king-getting/jiujiu-robot/docs/项目交接.md

# 啾啾 — 智能桌面聊天机器人 · 项目交接文档

> 最后更新：2026-08-23
> 交接对象：Kimi / KIMI Work
> 项目路径（Windows）：`C:\Users\89640\Documents\智能聊天机器人——啾啾\`

---

## 〇、2026-08-07 最新进展（追加）

| 事项 | 结果 |
|---|---|
| SD卡读写测试 | ✅ 跑通。坑：前几次失败根因是**MicroSD卡没插到底**，重插听到咔哒声后成功。测试代码见 `esp32/sd_test/` |
| 触摸调试 | ✅ **已定位（2026-08-14）**：根因=SD卡模块MISO霸占SPI总线（74HC125的OE焊死GND，空闲时把MISO钉高电平→读数8191）。拔掉SD模块MISO线后触摸恢复正常，TFT_eSPI `getTouch` 实测 `ok=1`、坐标/压力正常。详见下方"2026-08-14触摸排查结论" |
| BMP图片显示 | 代码已写（`esp32/bmp_test/`），用户侧编译报错exit status 1，报错原文未拿到，待定位 |
| Type-C读卡器 | ✅ 已到，可拷字体/图片进SD卡 |
| 手机APP | 需求+通信协议已定稿，见 `docs/手机APP开发交接.md`，交KIMI Work开发 |
| GitHub仓库 | ✅ 建立，持续同步 |

### 2026-08-14 触摸8191排查结论（已定位）

> 排查方式：arduino-cli 编译上传诊断程序 + 串口实测（诊断代码在 `03_ESP32代码\触摸调试\touch_bus_diag\`）

| 排查项 | 结论 |
|---|---|
| 恒定8191的直接原因 | **SD卡模块MISO霸占SPI总线**：带电平转换模块的74HC125缓冲芯片OE焊死GND，SD卡空闲时把MISO钉在高电平 → XPT2046读出来全是1（8191）。拔掉SD模块MISO线后触摸立即恢复正常 |
| TOUCH_CS配置 | `User_Setup.h`中`TOUCH_CS 21`必须保持启用（无`//`），曾被人为加注释，已纠正 |
| SPI触摸频率 | 2.5MHz → **1MHz**（`SPI_TOUCH_FREQUENCY`），低频率下读取更稳，已写入User_Setup.h |
| XPT2046芯片/触摸屏 | ✅ 完全正常：TFT_eSPI `getTouch` 返回 `ok=1`，坐标/压力读数正常（诊断v8实测） |
| CS链路（GPIO21→CS2） | ✅ 正常（诊断v7对照实验：选中/不选中读数不同） |

**遗留问题**：SD卡模块与触摸不能共存（MISO干扰）。解决方案（任选）：
1. 换3.3V直连、无电平转换的SD卡模块（¥5左右，无74HC125即无干扰）——推荐
2. 改造现有模块：把74HC125的OE脚从GND焊开，改接SD_CS（选中SD时才驱动MISO）
3. SD模块独立供电，触摸操作时断电（软件控制GPIO）

> 换新SD模块前，SD模块MISO线保持拔掉状态，触摸功能可正常使用。

---

---

## 〇.2、2026-08-22 半成品 v0.9（桌面摆件版）进展

> 目标：实现可演示的阶段性版本。核心演示 = **手机发消息 → WiFi/蓝牙 → ESP32 屏幕显示**。
> 已放弃（后续版本）：触摸交互 / SD卡 / 语音合成 / 中文字库。屏幕字体无中文字形，中文消息会显示为 `?`。

### 主程序 `esp32/jiujiu_main/jiujiu_main.ino`（v0.9，含BLE）

| 功能 | 说明 |
|---|---|
| 开机画面 | 粉底 + 狗头 + "JIUJIU / hello my friend" |
| 表情动画 | 可爱狗头 + 每3.2秒眨眼 |
| 鼓励语轮换 | 内置5句中文陪伴短句（我在呢/加油鸭/早点休息/今天也要开心/晚安），每12秒轮换 |
| WiFi | STA 连手机热点（`WIFI_SSID`/`WIFI_PWD`，需用户改）；失败自动切纯AP模式 |
| AP兜底 | SSID `Jiujiu` / 密码 `12345678` / IP `192.168.4.1` |
| HTTP接口 | `GET /`、`GET /api/status`、`GET /api/phrase/list`、`POST /api/message`、`GET /api/sensor`、`POST /api/phrase/add|del`（半成品仅回ok） |
| **BLE服务端** | 设备名 `JIUJIU`；服务/特征UUID与APP硬编码一致；写入JSON指令即上屏：`{ver:1,cmd:"msg",text:"..."}` → notify回执`{"ok":true}` |
| 传感器 | DHT11(GPIO26/27) + MQ-135(GPIO34) 已接并实测：串口每2秒输出温度/湿度/ADC |

> ⚠️ **编译必须指定 huge_app 分区**（BLE+TFT+WebServer 固件约1.75MB，超过默认1.25MB）：
> `arduino-cli compile --fqbn esp32:esp32:nodemcu-32s --build-property build.partitions=huge_app --build-property upload.maximum_size=3145728 <sketch>`
> 上传同理带 `--build-path`（产物内已含huge_app分区表）。

### 已实测（2026-08-22，PC直连AP验证）

- ✅ AP 正常广播、可连接（此前"找不到AP"是PC网卡只扫5GHz所致，非板子问题）
- ✅ `GET /` → `Jiujiu is alive! IP: 192.168.4.1 ...`
- ✅ `GET /api/status` → `{"ver":1,"ip":"192.168.4.1","wifi":false,"sd":false,"battery":0}`
- ✅ `GET /api/phrase/list` → 6句鼓励语JSON
- ⏳ `POST /api/message` 待手机APP实测（代码逻辑与APP协议一致：JSON body 进 `arg("plain")`，已核对WebServer源码）

### 课堂演示步骤（手机）

**方案A：蓝牙直连（推荐，无需WiFi）**
1. 开ESP32电源，等3秒（BLE 已在广播，设备名 `JIUJIU`）
2. 手机装 **nRF Connect**（免费）→ 扫描 → 连接 `JIUJIU`
3. 找到服务 `6a696f00-...` 下的写特征 `6a696f01-...` → 写入 `{"ver":1,"cmd":"msg","text":"I love you"}`（UTF-8）
4. 屏幕显示10秒；写特征 `6a696f02-...` 开启notify可收到回执 `{"ok":true}`

**方案B：WiFi + APP（啾啾APP完整功能）**
1. 开ESP32电源，等10秒进入AP模式（串口打印 `[WiFi] AP mode IP=192.168.4.1`）
2. 手机WiFi连 `Jiujiu`，密码 `12345678`
3. 打开啾啾APP → 设置页把 IP 改成 `192.168.4.1`，关掉 Mock 模式
4. 发消息 → 屏幕显示10秒；传感器页显示占位0值（后续接DHT11/MQ-135）

> 也可让手机开热点改名为 `Jiujiu-Hotspot`（密码 `12345678`），ESP32 STA 直连热点，APP 填热点内网IP。

### 手机APP构建环境（2026-08-23 已装好）

- JDK 17：`D:\android-dev\jdk\jdk-17.0.20+8`
- Android SDK：`D:\android-dev\sdk`（platform-34 / build-tools 34 / platform-tools；platform-34 为手动装配的 ext12 包，已改 package.xml/source.properties 为标准 android-34）
- Gradle 8.9：`D:\android-dev\gradle-8.9`（依赖缓存 `D:\android-dev\gradle_home`）
- 构建：`D:\android-dev\gradle-8.9\bin\gradle.bat -p <repo>\app assembleDebug`
- 说明：dl.google.com 被墙，`settings.gradle` 已配置阿里云镜像；SDK 包经腾讯镜像手动安装

### 后续待办

- [x] 手机实测蓝牙/HTTP消息上屏（2026-08-22 PC端bleak+curl双通道验证通过）
- [x] 啾啾APP"蓝牙直连发消息"入口（2026-08-23 完成，v0.2.0；APK已打包 `releases/jiujiu-app-v0.2.0-debug.apk`）
- [ ] APP正式签名（当前debug签名，可直装）
- [x] 固定中文陪伴短句（字模数组，无需SD；任意中文消息仍为 `?`）
- [ ] 触摸交互（等3.3V直连SD模块到货，见2026-08-14结论）
- [x] DHT11 / MQ-135 接入并串口实测（MQ-135当前3.3V临时供电，后续有10k/20k电阻改5V+分压）
- [ ] 18650电池 + 一体化电池盒（第二阶段）

## 一、项目概况

| 项目 | 说明 |
|---|---|
| 定位 | 桌面陪伴机器人 |
| 主控 | ESP32 NodeMCU-32S（已到手） |
| 屏幕 | ILI9341 2.8寸触摸屏（4线SPI + XPT2046触摸，11针模块，已到手） |
| 语音输入 | INMP441 I2S数字麦克风 + 云端ASR（已购） |
| 语音输出 | SYN6288 中文语音合成模块 + 喇叭（已购） |
| 传感器 | DHT11温湿度 + MQ-135空气质量（已购） |
| 存储 | SD卡模块 + MicroSD卡 8GB（已购，已跑通） |
| 供电 | 先USB调试 → 后期18650电池 3000mAh + 一体化电池盒 |
| 预算 | ¥800总盘，预计总花费¥250~350 |
| 外壳 | 楔形倾斜底座 80×110×45mm，屏幕微朝上，待做 |
| 手机APP | 安卓APK：远程发消息/看传感器/WiFi配网/鼓励语管理（开发中） |

---

## 二、硬件清单与采购状态

### 已到手

| 物品 | 状态 | 备注 |
|---|:----:|---|
| ESP32 NodeMCU-32S | ✅ | 主控，CH340串口芯片 |
| ILI9341 2.8寸触摸屏 | ✅ | 11针模块：VCC GND CLK MOSI RES DC BLK MISO CS1 CS2 PEN |
| ~~SD卡模块（带电平转换）~~ | ⚠️ 需更换 | VCC接5V，已跑通；但74HC125的OE焊死GND→MISO干扰触摸(8191)。**换3.3V直连无电平转换版** |
| MicroSD卡 8GB | ✅ | SDHC，FAT32 |
| Type-C读卡器 | ✅ | 拷文件用 |
| 轻触开关 6×6mm | ✅ | |
| 洞洞板 7×9cm 单面 | ✅ | SPI总线中转用 |
| 热熔胶枪 20W + 30根胶条 | ✅ | |

### 待购/在途清单

| 物品 | 预估价格 | 用途 | 备注 |
|---|---|---|---|
| 18650锂电池 3000mAh | ¥15-20 | 电池供电 | 单节3.7V |
| 一体化18650电池盒 | ¥10-15 | 电池充电+升压 | Type-C充电 + 5V输出 + 保护板 |
| DHT11温湿度模块 | ¥4-6 | 环境温湿度 | |
| MQ-135空气质量传感器 | ¥8-12 | 空气质量检测 | AO输出，需分压电阻 |
| INMP441 I2S数字麦克风模块 | ¥8-12 | 语音输入采集 | 全向型，I2S接口 |
| SYN6288语音合成模块 | ¥10-15 | 文字转语音输出 | 中文TTS，自带功放 |
| 8Ω 0.5W小喇叭 | ¥2-5 | 播放声音 | 接SYN6288输出 |
| 10kΩ + 20kΩ电阻 | ¥1 | MQ-135分压 | 防AO电压超3.3V烧GPIO |
| 杜邦线公母若干 | ¥5 | 接线 | |
| 金属带灯按钮 16mm自锁 | ¥5-8 | 外壳电源开关 | 外壳做好再买 |

---

## 三、引脚分配（定稿）

### 完整接线表

| 设备 | 信号 | ESP32引脚 | 备注 |
|---|---|---|---|
| 屏幕(ILI9341) | VCC | 3V3 | |
| 屏幕 | GND | GND | |
| 屏幕 | CLK(SCK) | GPIO18 | SPI总线共用 |
| 屏幕 | MOSI(SDA) | GPIO23 | SPI总线共用 |
| 屏幕 | MISO | GPIO19 | SPI总线共用 |
| 屏幕 | CS1(屏片选) | GPIO15 | |
| 屏幕 | DC | **GPIO5** | ⚠️ 之前错定为GPIO2，这是白屏根因 |
| 屏幕 | RES(RST) | GPIO4 | |
| 屏幕 | BLK(背光) | GPIO25 | |
| 触摸(XPT2046) | CS2(触摸片选) | GPIO21 | ✅ 已定位(8-14) |
| 触摸 | PEN(中断) | 悬空 | 未用 |
| SD卡模块 | SD_CS | GPIO14 | SPI总线共用CLK/MOSI/MISO |
| DHT11 | VCC | GPIO27 | GPIO供电（节能可断电） |
| DHT11 | DATA | GPIO26 | |
| MQ-135 | VCC | 5V | |
| MQ-135 | AO | GPIO34 | 需10k+20k分压（5V→3.3V） |
| SYN6288(TTS) | RX | ← ESP32 GPIO17(TX) | Serial2 |
| SYN6288 | TX | → ESP32 GPIO16(RX) | Serial2 |
| INMP441(麦克风) | BCLK | GPIO32 | I2S位时钟 |
| INMP441 | WS(LRCK) | GPIO33 | I2S左右声道选择 |
| INMP441 | DATA(SD) | GPIO22 | I2S数据输入到ESP32 |
| 喇叭 | + | SYN6288 SPK+ | 不占ESP32引脚 |
| 喇叭 | - | SYN6288 SPK- | |

### 引脚禁忌（严禁接）

| 引脚 | 原因 |
|---|---|
| GPIO6(板上丝印"CLK") | 内部flash专用 |
| GPIO7~11(SD0~3, CMD) | 内部flash专用 |
| GPIO0 / GPIO2 / GPIO12 | STRAP引脚，上电时电平决定启动模式，慎用 |
| GPIO35 / GPIO36(VP) / GPIO39(VN) | 仅输入，无内部上拉电阻 |

### 剩余可用引脚

| 引脚 | 状态 |
|---|---|
| GPIO13 | 空闲备用（触摸调试候选CS） |

---

## 四、SPI总线架构

SPI总线三设备共享，各自CS片选分离：

```
ESP32                    SPI总线
├── GPIO18(CLK) ────────┬── 屏幕 CLK
│                        ├── 触摸 CLK
│                        └── SD卡 CLK
├── GPIO23(MOSI) ───────┬── 屏幕 MOSI
│                        ├── 触摸 MOSI
│                        └── SD卡 MOSI
├── GPIO19(MISO) ───────┬── 屏幕 MISO
│                        ├── 触摸 MISO
│                        └── SD卡 MISO
├── GPIO15(CS) ─────────── 屏幕 CS1
├── GPIO21(CS) ─────────── 触摸 CS2
└── GPIO14(CS) ─────────── SD卡 SD_CS
```

原理：CLK/MOSI/MISO广播共用，CS一人一根，ESP32拉低谁的CS谁应答，其余设备MISO高阻装死。
SPI频率：屏幕40MHz（实测正常）；SD卡400kHz~4MHz；触摸**1MHz**（8-14从2.5MHz降频，读取更稳）。

⚠️ 多设备共总线时，代码里要把不用的CS全部pinMode+拉高，避免悬空CS被误选中干扰总线。

---

## 五、开发环境配置

| 项目 | 版本/路径 | 备注 |
|---|---|---|
| Arduino IDE | 2.x | 安装路径：`E:\arduino\Arduino IDE\` |
| ESP32 Arduino Core | **3.3.10** | 通过ghfast.top国内镜像下载工具链 |
| TFT_eSPI库 | 2.5.43 | Bodmer出品，手动下载zip安装（IDE代理坏了） |
| arduino-cli | 1.5.1 | 命令行编译/上传，位于 `D:\KimiData\kimi\Workspaces\jiujiu\tools\arduino-cli\` |
| CH340驱动 | 已装 | USB串口驱动 |
| 项目根目录 | `C:\Users\89640\Documents\智能聊天机器人——啾啾\` | |

### TFT_eSPI 配置文件

路径：`C:\Users\89640\Documents\Arduino\libraries\TFT_eSPI\User_Setup.h`
模板见仓库 `esp32/config/User_Setup.h`。关键配置项：

```c
#define TFT_MISO 19
#define TFT_MOSI 23
#define TFT_SCLK 18
#define TFT_CS   15
#define TFT_DC    5   // ⚠️ 关键！之前错写为2导致白屏
#define TFT_RST   4
#define TFT_BL   25
#define TOUCH_CS 21   // ✅ 保持启用，勿加//注释

#define SPI_FREQUENCY  40000000   // 40MHz
#define SPI_TOUCH_FREQUENCY  1000000   // 8-14已降频：2.5MHz下读取不稳

#define TFT_ROTATION 1   // 0=竖屏, 1=横屏90°
```

### 配置字段名注意

TFT_eSPI的`setup_t`结构体字段名（用于代码中读取配置）：
- `pin_tft_mosi` / `pin_tft_clk` / `pin_tft_cs` / `pin_tft_dc` / `pin_tft_rst` / `pin_tft_miso` / `pin_tch_cs`
- ⚠️ **没有** `pin_tft_bl`（背光引脚不在setup_t里，需自己用digitalWrite控制）

---

## 六、已完成进度

| 任务 | 状态 | 说明 |
|---|:----:|---|
| Blink链路验证 | ✅ | LED闪烁，确认USB串口通信正常 |
| 屏幕点亮 | ✅ | 颜色测试+文字"JIUJIU"正常显示 |
| TFT_eSPI库安装 | ✅ | 2.5.43版，手动curl下载zip+解压 |
| ESP32 core升级 | ✅ | 1.0.6 → 3.3.10，用ghfast.top镜像 |
| User_Setup.h配置 | ✅ | 引脚写死，DC=GPIO5是关键修正 |
| DC引脚修正 | ✅ | GPIO2 → GPIO5，解决白屏问题 |
| 引脚分配定稿 | ✅ | 含屏幕/触摸/SD卡/DHT11/MQ-135/语音模块 |
| 供电方案确定 | ✅ | 18650单节3.7V + 一体化电池盒 |
| 语音方案确定 | ✅ | 云端自然对话（INMP441+云端ASR+大模型+SYN6288） |
| SD卡读写测试 | ✅ | 2026-08-07跑通，代码见esp32/sd_test |
| 读卡器 | ✅ | Type-C读卡器到货 |
| 中文字体显示 | ⏳ | 读卡器已到，待做字体转换 |
| BMP图片显示 | 🔧 | 代码已写，编译报错待定位 |
| 触摸交互 | ✅ 根因已定位 | 8191根因=SD模块MISO干扰（拔线验证正常），换SD模块后收尾 |
| 语音模块接入 | ⏳ | 模块待接 |
| 手机APP | 📋 | 需求文档完成，待KIMI Work开发 |

---

## 七、语音交互方案（云端自然对话）

### 数据流

```
你说话 → INMP441采集(I2S) → ESP32录音(PCM 16kHz/16bit)
  → WiFi上传云端ASR(百度/讯飞) → 识别文字
  → 大模型API(通义千问/DeepSeek) → 回复文字
  → ESP32串口发给SYN6288 → 离线合成中文语音 → 喇叭播放
```

### 设计要点

| 环节 | 方案 | 说明 |
|---|---|---|
| 语音采集 | INMP441 I2S数字麦 | 比模拟麦抗干扰强 |
| 语音识别 | 百度/讯飞云端ASR | 需API密钥，有免费额度，16kHz/16bit/单声道 |
| 对话生成 | 大模型API | 通义千问/DeepSeek等 |
| 语音输出 | SYN6288离线TTS | 延迟<1秒，断网也能说预置话术 |
| 网络 | ESP32自带WiFi | 连家里/手机热点 |

---

## 八、存储方案

| 存储位置 | 容量 | 用途 |
|---|---|---|
| SD卡(MicroSD 8GB) | ~8GB | 中文字体/图片/鼓励语库/配置文件/预置提示音 |
| SPIFFS(ESP32内置Flash) | ~1MB | 运行配置/触摸校准数据/WiFi密码缓存 |

---

## 九、供电方案

调试阶段：USB直接供电。
电池阶段：18650(3.7V 3000mAh) → 一体化电池盒(保护板+升压5V) → ESP32 5V引脚。

### 功耗估算

| 设备 | 工作电流 |
|---|---|
| ESP32(WiFi活跃) | ~80-120mA |
| ILI9341屏幕+背光 | ~40-60mA |
| SYN6288+喇叭(播放时) | ~80-120mA |
| INMP441 | ~2mA |
| DHT11 | ~1-2mA |
| MQ-135(预热后) | ~150mA |
| **全开总计** | **~350-460mA** |

3000mAh续航：全开约6-8小时，省电模式约10-15小时。

---

## 十、待办任务路线图

详见 `docs/任务树状图.md`（WBS全任务分解）。

---

## 十一、技术注意事项与踩坑记录

### 1. DC引脚（最关键的坑）
白屏根因：DC写GPIO2，实际接GPIO5。解决：`#define TFT_DC 5`。

### 2. Arduino项目名必须英文
文件夹名 = .ino文件名，必须纯英文。

### 3. TFT_eSPI库安装（代理坏了）
手动curl下载zip + Python解压到libraries目录。

### 4. ESP32 Core升级（大文件下载卡住）
用ghfast.top镜像加速，下载后放staging目录跳过IDE下载。

### 5. TFT_eSPI API注意
- 无`readID()` → 用`readcommand32(0x04)`
- setup_t字段带`pin_tft_`前缀，无`pin_tft_bl`，背光手动控制GPIO25

### 6. 串口占用（WindowsError 31）
关串口监视器→拔插USB→重选端口→波特率115200。
IDE 2.x串口监视器上传后经常不重连：上传完按RST键或重开监视器。

### 7. MQ-135注意事项
AO必须10k+20k分压到3.3V；预热24-48小时；功耗大建议间歇采样。

### 8. 3V3接口只有一个
多设备3.3V用洞洞板并联。

### 9. SD卡初始化失败（2026-08-07新增，已解决）
- 现象：SD.begin重试5次全失败，换CS引脚/降速/拔屏幕全无效
- 根因：**MicroSD卡没插到底，卡座接触不良**
- 教训：插卡按到底听到咔哒声；排查硬件时"重新插拔"是成本最低的必杀技

### 10. 触摸无应答8191（2026-08-07新增，**2026-08-14已解决**）
- 现象：getTouchRaw读数恒定x=8191 y=8191（全1）= XPT2046未被选中
- 已排除：换CS2杜邦线无效
- ✅ 2026-08-14 已解决：根因是SD卡模块MISO霸占总线（74HC125 OE焊死GND），拔线后触摸正常；另确认TOUCH_CS保持启用、触摸频率降到1MHz

---

## 十二、关键文件位置

| 文件 | 位置 | 说明 |
|---|---|---|
| 项目交接文档 | 本仓库 `docs/项目交接.md` | GitHub为准 |
| APP开发交接 | 本仓库 `docs/手机APP开发交接.md` | |
| 各测试代码 | 本仓库 `esp32/` | 见各文件夹 |
| 屏幕诊断程序 | 电脑 `...\03_ESP32代码\屏幕驱动\screen_debug\` | ⚠️ 待补传到仓库 |
| TFT_eSPI配置 | 电脑 `...\libraries\TFT_eSPI\User_Setup.h` | ⚠️ 待补传完整版 |

---

## 十三、状态指示灯说明

| 指示灯 | 状态 | 含义 |
|---|---|---|
| 红灯 | 常亮 | 电源接通 |
| 蓝灯(GPIO2) | 闪烁 | 程序正在运行 |

---

## 附：给接手者的建议

1. **先跑通显示**：中文字体是所有UI的基础，读卡器已到，下一步做字体转换
2. **语音分步做**：先让SYN6288会说话（最简单），再接麦克风，最后接云端API
3. **API密钥提前注册**：百度智能云、讯飞、通义千问/DeepSeek
4. **功耗管理**：MQ-135最耗电，电池模式定时采样
5. **WiFi配置**：先用手机热点测试，后期做APP蓝牙配网（协议见APP交接文档）
6. **录音格式**：16kHz/16bit/单声道PCM
7. **APP与固件并行**：APP侧可先用mock服务器调试，不等硬件
