king-getting/jiujiu-robot/docs/任务树状图.md

# 啾啾项目 · 全任务分解树状图（WBS）

```mermaid
graph LR
    ROOT[啾啾<br/>智能桌面聊天机器人]

    ROOT --> A[一、硬件基础 ✅已完成]
    A --> A1[ESP32点亮+串口验证]
    A --> A2[ILI9341屏幕驱动点亮<br/>DC=GPIO5]
    A --> A3[引脚分配定稿+SPI架构]
    A --> A4[SD卡读写测试✅<br/>2026-08-07]

    ROOT --> B[二、软件基础 🔶无硬件依赖]
    B --> B1[触摸校准+按钮交互<br/>🔧调试中8191]
    B --> B2[WiFi联网 手机热点]
    B --> B3[云端API注册<br/>百度ASR+大模型Key]
    B --> B4[大模型API对接]
    B --> B5[UI布局+鼓励语文案30条]
    B --> B6[BMP图片显示<br/>🔧编译报错待修]

    ROOT --> C[三、显示系统 📀读卡器已到]
    C --> C1[中文字体转换与显示]
    C --> C2[啾啾表情图库]
    C --> C3[鼓励语库存SD卡+随机读取]

    ROOT --> D[四、传感器 📦待接入]
    D --> D1[DHT11温湿度+屏幕显示]
    D --> D2[MQ-135分压+空气质量]

    ROOT --> E[五、语音交互 ❤️核心功能]
    E --> E1[SYN6288接线+TTS播报]
    E --> E2[INMP441接线+I2S录音]
    E --> E3[云端ASR对接 录音→文字]
    E --> E4[全链路整合<br/>说话→识别→回复→播报]
    E --> E5[人格prompt设定<br/>向主人汇报风格]

    ROOT --> F[六、手机APP 📋需求已定稿]
    F --> F1[安卓APK框架+通信层]
    F --> F2[远程发消息到屏幕]
    F --> F3[传感器数据查看]
    F --> F4[BLE WiFi配网]
    F --> F5[鼓励语管理]
    F --> F6[ESP32端HTTP/BLE服务<br/>固件配合开发]

    ROOT --> G[七、供电功耗 📦等电池盒]
    G --> G1[18650电池供电切换+续航实测]
    G --> G2[低功耗优化 MQ-135间歇采样]

    ROOT --> H[八、外壳与收尾]
    H --> H1[楔形外壳制作 热熔胶原型]
    H --> H2[开机问候+断网兜底话术]
    H --> H3[整体联调+交付演示]

    style A fill:#2ecc71,color:#fff
    style B fill:#e67e22,color:#fff
    style C fill:#3498db,color:#fff
    style D fill:#9b59b6,color:#fff
    style E fill:#e74c3c,color:#fff
    style F fill:#1abc9c,color:#fff
    style G fill:#16a085,color:#fff
    style H fill:#7f8c8d,color:#fff
```

## 优先级与关键路径

1. **现在可做**：B分支（软件基础）——触摸调试收尾、WiFi、API注册、大模型对接
2. **读卡器到了**：C分支（显示系统）——中文字体是所有UI的根基
3. **语音模块接入**：E分支（核心灵魂）——先TTS会说话，再录音，再全链路
4. **APP并行开发**：F分支——KIMI Work按 `docs/手机APP开发交接.md` 开工，硬件端配合实现HTTP/BLE服务
5. D、G、H收尾补强

> 优先级排序：中文显示 > 语音对话 > 触摸交互 > APP联动 > 传感器 > 电池/外壳
