king-getting/jiujiu-robot/esp32/jiujiu_main/gougou_preview.png

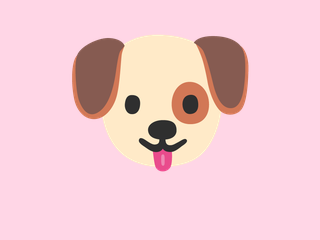
esp32/jiujiu_main/gougou_preview.png
