king-getting/jiujiu-robot/esp32/jiujiu_main/chinese_phrases.h

#ifndef CHINESE_PHRASES_H
#define CHINESE_PHRASES_H

#include <Arduino.h>

static const uint8_t zh_phrase_0[] PROGMEM = {
  0,0,0,0,0,0,0,0,0,0,6,0,0,0,0,0,
  0,0,0,38,0,0,48,0,0,63,240,3,246,192,0,48,
  0,31,63,240,31,134,96,0,48,0,31,176,16,1,134,48,
  0,112,0,17,48,16,1,134,0,31,255,248,17,48,16,1,
  134,0,0,64,0,17,63,240,63,255,252,0,194,0,17,48,
  0,1,134,0,1,130,0,17,48,0,1,134,16,3,130,0,
  17,50,0,1,134,56,3,2,0,17,50,48,1,242,48,7,
  127,240,31,50,112,31,226,96,14,127,240,31,51,192,31,131,
  192,30,2,0,17,163,128,1,131,192,50,2,0,16,98,0,
  1,131,128,2,2,0,16,98,0,1,135,140,2,2,0,0,
  66,12,1,156,204,2,2,0,0,195,24,7,56,124,2,127,
  248,1,131,248,7,0,56,2,255,252,0,128,0,0,0,0,
  2,0,0,0,0,0,0,0,0,0,0,0,0,0,0,0,
  0,0,0,0,0,0,0,0,
};
#define ZH_PHRASE_0_W 72

static const uint8_t zh_phrase_1[] PROGMEM = {
  0,0,0,0,0,0,0,0,0,0,0,0,0,0,0,0,
  0,0,3,0,0,0,2,0,0,1,128,3,0,0,0,3,
  0,0,1,0,3,0,0,14,3,0,63,231,248,3,3,248,
  7,3,0,50,102,24,31,242,24,3,3,0,50,100,152,3,
  18,24,0,127,248,50,100,152,3,18,24,0,99,24,54,100,
  216,3,18,24,24,67,24,63,228,24,3,18,24,30,67,24,
  50,100,112,2,18,24,6,67,24,50,100,96,2,50,24,0,
  67,24,50,100,0,6,50,24,0,127,248,50,103,252,6,50,
  24,2,67,24,63,224,12,6,50,24,6,67,24,54,96,12,
  12,51,248,6,67,24,50,0,12,12,51,248,12,67,24,2,
  31,204,24,114,24,12,99,24,2,0,12,56,226,24,24,127,
  248,2,0,12,16,2,0,24,64,24,2,0,120,0,0,0,
  0,64,24,6,0,120,0,0,0,0,0,0,0,0,0,0,
  0,0,0,0,0,0,0,0,
};
#define ZH_PHRASE_1_W 72

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
  6,14,0,3,255,224,16,63,252,4,4,0,6,1,192,6,
  16,8,0,7,0,0,240,0,6,14,0,0,0,0,0,0,
  0,0,0,0,0,0,0,0,0,0,0,0,0,0,0,0,
  0,0,0,0,0,0,0,0,0,0,0,0,0,0,0,0,
  0,0,0,0,0,0,0,0,0,0,0,0,0,0,0,0,
  0,0,0,0,0,0,0,0,0,0,0,0,0,0,0,0,
};
#define ZH_PHRASE_19_W 192

#define ZH_PHRASE_COUNT 40

struct ZhPhrase { const uint8_t* data; uint16_t w; const char* text; };
static const ZhPhrase zh_phrases[ZH_PHRASE_COUNT] = {
  { zh_phrase_0, ZH_PHRASE_0_W, "你好，我是啾啾" },
  { zh_phrase_1, ZH_PHRASE_1_W, "加油鸭" },
  { zh_phrase_2, ZH_PHRASE_2_W, "早点休息" },
  { zh_phrase_3, ZH_PHRASE_3_W, "今天也要开心" },
  { zh_phrase_4, ZH_PHRASE_4_W, "晚安" },
  { zh_phrase_5, ZH_PHRASE_5_W, "Keep going" },
  { zh_phrase_6, ZH_PHRASE_6_W, "Good night" },
  { zh_phrase_7, ZH_PHRASE_7_W, "Take a break" },
  { zh_phrase_8, ZH_PHRASE_8_W, "Love yourself" },
  { zh_phrase_9, ZH_PHRASE_9_W, "你真的很棒" },
  { zh_phrase_10, ZH_PHRASE_10_W, "慢慢来也没关系" },
  { zh_phrase_11, ZH_PHRASE_11_W, "我一直陪着你" },
  { zh_phrase_12, ZH_PHRASE_12_W, "抱抱你" },
  { zh_phrase_13, ZH_PHRASE_13_W, "明天会更好" },
  { zh_phrase_14, ZH_PHRASE_14_W, "记得喝水" },
  { zh_phrase_15, ZH_PHRASE_15_W, "别太累了" },
  { zh_phrase_16, ZH_PHRASE_16_W, "相信自己" },
  { zh_phrase_17, ZH_PHRASE_17_W, "你是被爱着的" },
  { zh_phrase_18, ZH_PHRASE_18_W, "吃顿好的" },
  { zh_phrase_19, ZH_PHRASE_19_W, "你已经做得很好了" },
  { nullptr, 0, "今天辛苦啦" },
  { nullptr, 0, "你已经很努力了" },
  { nullptr, 0, "我会一直陪着你" },
  { nullptr, 0, "累了就休息一下" },
  { nullptr, 0, "一切都会好起来" },
  { nullptr, 0, "你值得被温柔对待" },
  { nullptr, 0, "做你自己就很好" },
  { nullptr, 0, "小步走也是前进" },
  { nullptr, 0, "今天也谢谢你" },
  { nullptr, 0, "不要忘记微笑" },
  { nullptr, 0, "呼吸一下，慢慢来" },
  { nullptr, 0, "你是独一无二的" },
  { nullptr, 0, "没关系，明天再来" },
  { nullptr, 0, "我会为你加油" },
  { nullptr, 0, "You are enough" },
  { nullptr, 0, "It's okay to rest" },
  { nullptr, 0, "One step at a time" },
  { nullptr, 0, "You did well today" },
  { nullptr, 0, "Be kind to yourself" },
  { nullptr, 0, "I'm here with you" },
};

#endif
