king-getting/jiujiu-robot/esp32/jiujiu_main/gougou.h

#ifndef GOUGOU_H
#define GOUGOU_H

#include <Arduino.h>

#define GOUGOU_W 320
#define GOUGOU_H 240

static const uint16_t gougou_bmp[320*240] PROGMEM = {
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
};

#endif
