king-getting/jiujiu-robot/(commit log)

2026-08-13 docs: 项目交接文档（更新至2026-08-07）+ APP开发交接 + 任务树状图
2026-08-13 esp32: sd_test/touch_diag/touch_test/bmp_test + TFT_eSPI配置模板
2026-08-13 app: Android工程骨架 + 资源/布局（Gradle、Manifest、主题、四页面布局）
2026-08-13 app: Kotlin源码（通信层HTTP/Mock/BLE + 四功能页面）+ README构建与协议文档
2026-08-14 docs: 触摸8191排查结论(2026-08-14) + SD模块更换建议
2026-08-21 esp32: jiujiu_main 半成品v0.9 (WiFi AP/STA + HTTP消息上屏 + 表情动画) + docs: 2026-08-22 进展与演示步骤
2026-08-22 esp32: 增加BLE服务端(JIUJIU)消息上屏 + 传感器占位 + docs: BLE/WiFi双通道演示步骤与huge_app编译说明
2026-08-22 app: 蓝牙直连发消息入口(BleMessenger) + 修复BleProvisioner编译错误 + 阿里云镜像源 + docs更新
2026-08-23 v0.2.0: 传感器接入 + 狗头待机 + 中文陪伴短句 + APP UI/蓝牙修复
    [chinese_phrases.h, jiujiu_main.ino]
2026-08-24 v0.3.0: 内置可爱狗头、关闭SD默认读取，加快开机并修复白屏
2026-08-24 v0.3.1: SD独立SPI记录传感器CSV，APP传感器页每2秒自动刷新
2026-08-24 v0.4.0: 20句鼓励语库、SD文件包与固件短语加载
2026-08-25 v0.4.1: GB2312全字库任意中文显示 + DeepSeek大模型接口
2026-08-25 app v0.4.1: 消息页新增大模型陪伴聊天入口，支持 cmd:chat
2026-08-25 fix: 修复消息页白屏与字母缺列，中文英文显示正常
2026-08-25 v0.4.2: 固件支持BLE蓝牙配网连接手机热点
2026-08-25 v0.4.2: 修复BLE配网回执分片解析，App版本0.4.2
2026-08-25 v0.4.3: 待机整屏定时重绘，修复长时间白屏
2026-08-25 v0.4.4: 配网超时延长至30秒，修复配网超时
2026-08-25 v0.4.5: 固件BLE回执按20字节分包发送
2026-08-25 v0.4.6: 待机白屏自动重初始化屏幕并降低SPI频率
2026-08-25 v0.4.7: 白屏检测,发现全白立即自动重初始化屏幕
2026-08-25 v0.4.8: 固定公共DNS并输出HTTP错误原因,修复大模型连接失败
2026-08-25 v0.4.9: DeepSeek固定可用IP,避免解析到被拒IP
2026-08-25 v0.5.0: AI聊天释放蓝牙内存修复TLS;扩展回复范围
2026-08-25 docs: 更新项目定位为桌面智能摆件
2026-09-11 chore: 补充屏幕调试程序与实际User_Setup配置
2026-09-12 fix: 鼓励语切换清除上一句并新增3MB大程序分区
    [partitions.csv]
2026-09-12 feat: 鼓励语库扩充到40条并支持SD任意文本显示
2026-09-12 feat: 开机首句改为你好我是啾啾
